UBNanosatLab/lfr-hardware/README.md

# LinkSat-comms-radio-HW
Hardware design files for the LinkSat communications radio
