UBNanosatLab/lfr-hardware/Bill of materials - rev1A.ods

RefDes | Value | Name | Part number | Quantity | note | qty to order | source
C1, C2, C22, C23 | 47uF 16V X6S 1210 | CAP_1210 | GRT32EC81C476KE13L | 4 | Alternate: GRM32ER61C476KE15L or equiv for non-flight | 12 | digikey
C3, C6, C9, C10, C11, C13, C16, C17, C18, C26 | 0.1uF 20% 25V X5R | CAP_0603_SM | CGA3E2X8R1E104K080AA | 10 |  | 25 | mouser
C4, C5, C24, C25 | 1uF 20% 10V X5R | CAP_0603_SM | CGA3E2X5R1A105M080AA | 4 |  | 15 | mouser
C7, C14 | 100pF 10% 25V C0G | CAP_0603_SM | VJ0603A101KXACW1BC | 2 |  | 5 | mouser
C8, C12, C27 | 1500pF 10% 25V C0G | CAP_0603_SM | CGA3E2C0G1H152J080AA | 3 |  | 10 | mouser
C15 | 10uF 50V X5R 1210 | CAP_1210 | UMK325BJ106MM | 1 | substituting C3225X5R1H106K250AB | 3 | digikey
C19, C20 | 10pF 10% 25V C0G | CAP_0603_SM | AC0603DRNPO9BN100 | 2 |  | 10 | mouser
C21 | 6.8pF C0G | CAP_0603_SM | 251R14S6R8CV4T | 1 | use low loss, tight tolerance parts | 10 | mouser
CF1 | 15pF C0G | CAP_0603_SM | 251R14S150JV4T | 1 | use low loss, tight tolerance parts | 10 | mouser
CF2, CF3 | DNP | CAP_0603_SM |  | 2 | use low loss, tight tolerance parts
CM1, CM2 | 6.2pF C0G | CAP_0603_SM | 251R14S6R2CV4T | 2 | use low loss, tight tolerance parts | 10 | mouser
CM3 | 11pF C0G | CAP_0603_SM | 251R14S110JV4T | 1 | use low loss, tight tolerance parts | 10 | mouser
CM4 | 10pF C0G | CAP_0603_SM | 251R14S100JV4T | 1 | use low loss, tight tolerance parts | 10 | mouser
CR1 | 4.7pF C0G | CAP_0603_SM | 251R14S4R7BV4T | 1 | use low loss, tight tolerance parts | 10 | mouser
CR2 | 2.2pF C0G | CAP_0603_SM | 251R14S2R2BV4T | 1 | use low loss, tight tolerance parts | 4 | digikey
CTX0 | 9.1pF C0G | CAP_0603_SM | 251R14S9R1CV4T | 1 | use low loss, tight tolerance parts | 10 | mouser
D1 |  | 1N4148WS-7-F |  | 1 |  | 5 | mouser
J1 |  | SMA_EDGE | CON-SMA-EDGE-S | 1 |  | 3 | digikey
J2 |  | CLT-110-02-L-D-BE | CLT-110-02-L-D-BE-A | 1 |  | 2 | digikey
L1 | 10uH | XAL7030 | XAL7030-103MEC | 1 |  | 2 | mouser
L4 | BLM21PG220SN1D | IND_0805 | BLM21PG220SN1D | 1 |  | 3 | mouser
LCHOKE | 220nH | IND_0603_SM | L-14WR22GV4E | 1 | use low loss, tight tolerance parts | 3 | mouser
LF1, LF2 | 0 ohm | IND_0603_SM |  | 2 | use low loss, tight tolerance parts
LM0 | 33nH | IND_0603_SM | L-14W33NGV4E | 1 | use low loss, tight tolerance parts | 10 | mouser
LM1, LM2 | 30nH | IND_0603_SM | LQW18AN30NJ8ZD | 2 | use low loss, tight tolerance parts | 10 | mouser
LM3 | 16nH (15?) | IND_0603_SM | LQW18AN16NJ8ZD | 1 | use low loss, tight tolerance parts | 10 | mouser
LR1 | 62nH | IND_0603_SM | LQW18AN62NG0ZD | 1 | use low loss, tight tolerance parts | 10 | mouser
LR2 | 56nH | IND_0603_SM | LQW18AN58NJ8ZD | 1 | use low loss, tight tolerance parts | 10 | mouser
wired to P1/P2/P3 | TMP36 |  | TMP36GT9Z | 1 |  | 2 | mouser
PA1 |  | RA07H4047M |  | 1
R1 | 51k 1% | RES_0603_SM | ERJ-3EKF5102V | 1 |  | 10 | mouser
R2, R11, R13 | 220k 1% | RES_0603_SM | ERJ-3EKF2203V | 3 |  | 10 | mouser
R3 | 4k7 5% | RES_0603_SM | ERJ-3EKF4701V | 1 |  | 10 | mouser
R4, R5, R6 | 10k 5% | RES_0603_SM | RK73B1JTTD103J | 3 |  | 10 | mouser
R7 | 1k 5% | RES_0603_SM | RK73B1JTTDD102J | 1 |  | 10 | mouser
R8 | 47.5k 1% | RES_0603_SM | ERJ-3EKF4752V | 1 |  | 10 | mouser
R9 | 443k 1% | RES_0603_SM | ERJ-3EKF4423V | 1 |  | 10 | mouser
R10 | R025 1% | RES_0603_SM | WSL0603R0250FEA | 1 |  | 3 | mouser
R12 | 47k 5% | RES_0603_SM | use R8 (47.5k) | 1
U1 |  | LT8611 | LT8611IUDD#PBF | 1 |  | 2 | digikey
U2 |  | SI4464 | SI4464-B1B-FMR | 1 |  | 3 | mouser
U3 |  | MCP4728 | MCP4728-E/UN | 1 |  | 3 | digikey
U4 |  | SKY13405-490LF | SKY13405-490LF | 1 | Many on hand. Do not order.
U6 |  | TPS2553 | TPS2553DBVR | 1 |  | 2 | mouser
U7 |  | MSP430FR5994IPM | MSP430FR5994IPMR | 1 |  | 2 | mouser
XO1 |  | 520L15IA26M0000 |  | 1 |  | 3 | mouser
Y1 | 16MHz | CX3225SB16000H0FLJCC |  | 1 |  | 3 | digikey
Tuning components
Capacitors
 | 2.0pF | 251R14S2R0BV4T |  |  |  | 10 | mouser
2.2pF C0G
 | 2.7pF | 251R14S2R7BV4T |  |  |  | 10 | mouser
 | 3.9pF | 251R14S3R9BV4T |  |  |  | 10 | mouser
4.7pF C0G
 | 5.1pF | 251R14S5R1CV4T |  |  |  | 10 | mouser
 | 5.6pF | 251R14S5R6CV4T |  |  |  | 10 | mouser
6.2pF C0G
6.8pF C0G
 | 7.5pF | 251R14S7R5CV4T |  |  |  | 10 | mouser
 | 8.2pF | 251R14S8R2CV4T |  |  |  | 10 | mouser
9.1pF C0G
10pF C0G
11pF C0G |  |  |  |  |  | 10 | mouser
 | 12pF | 251R14S120JV4T |  |  |  | 10 | mouser
 | 13pF | 251R14S130JV4T
15pF C0G
Inductors
 | 13nH | LQW18AN13NJ8ZD |  |  |  | 5
 | 15nH | LQW18AN15NJ8ZD |  |  |  | 5
16nH (15?)
 | 18nH | LQW18AN18NJ8ZD |  |  |  | 5 | mouser
 | 27nH | LQW18AN27NJ8ZD |  |  |  | 10 | mouser
30nH
33nH
 | 36nH | LQW18AN36NJ8ZD |  |  |  | 5 | mouser
