UBNanosatLab/lfr-hardware/Schematic - LinkSat radio rev1.pdf

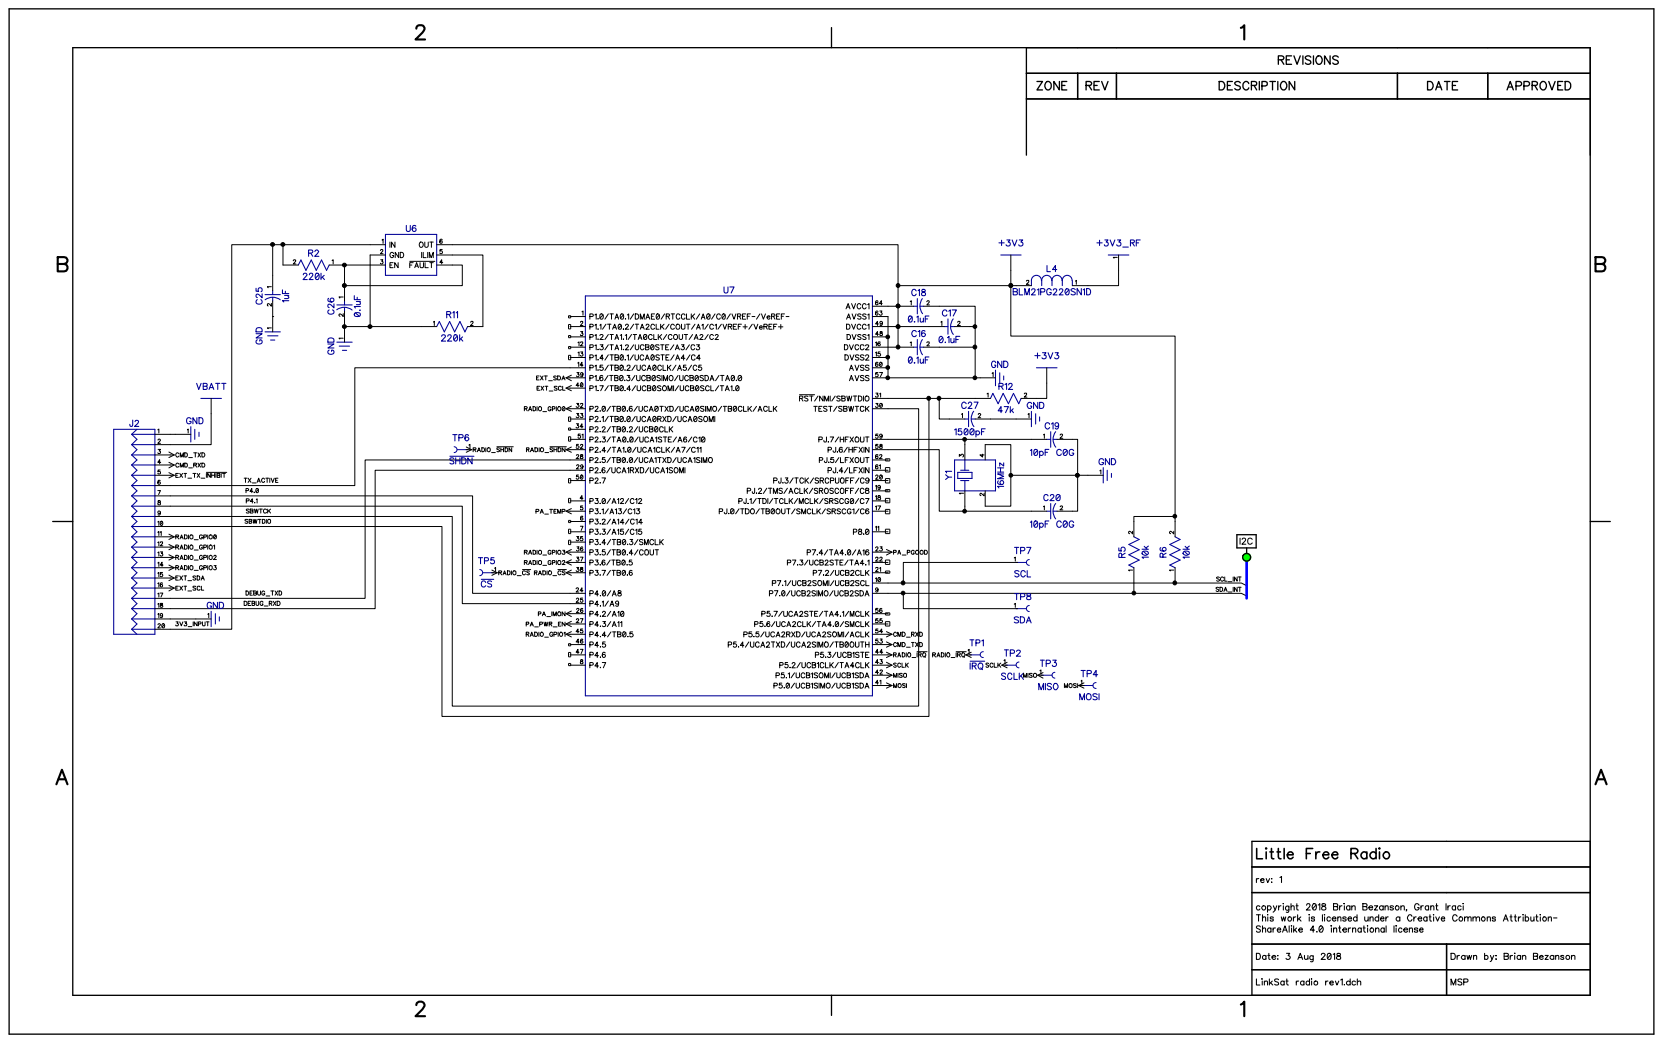
[picture p1: page 1]

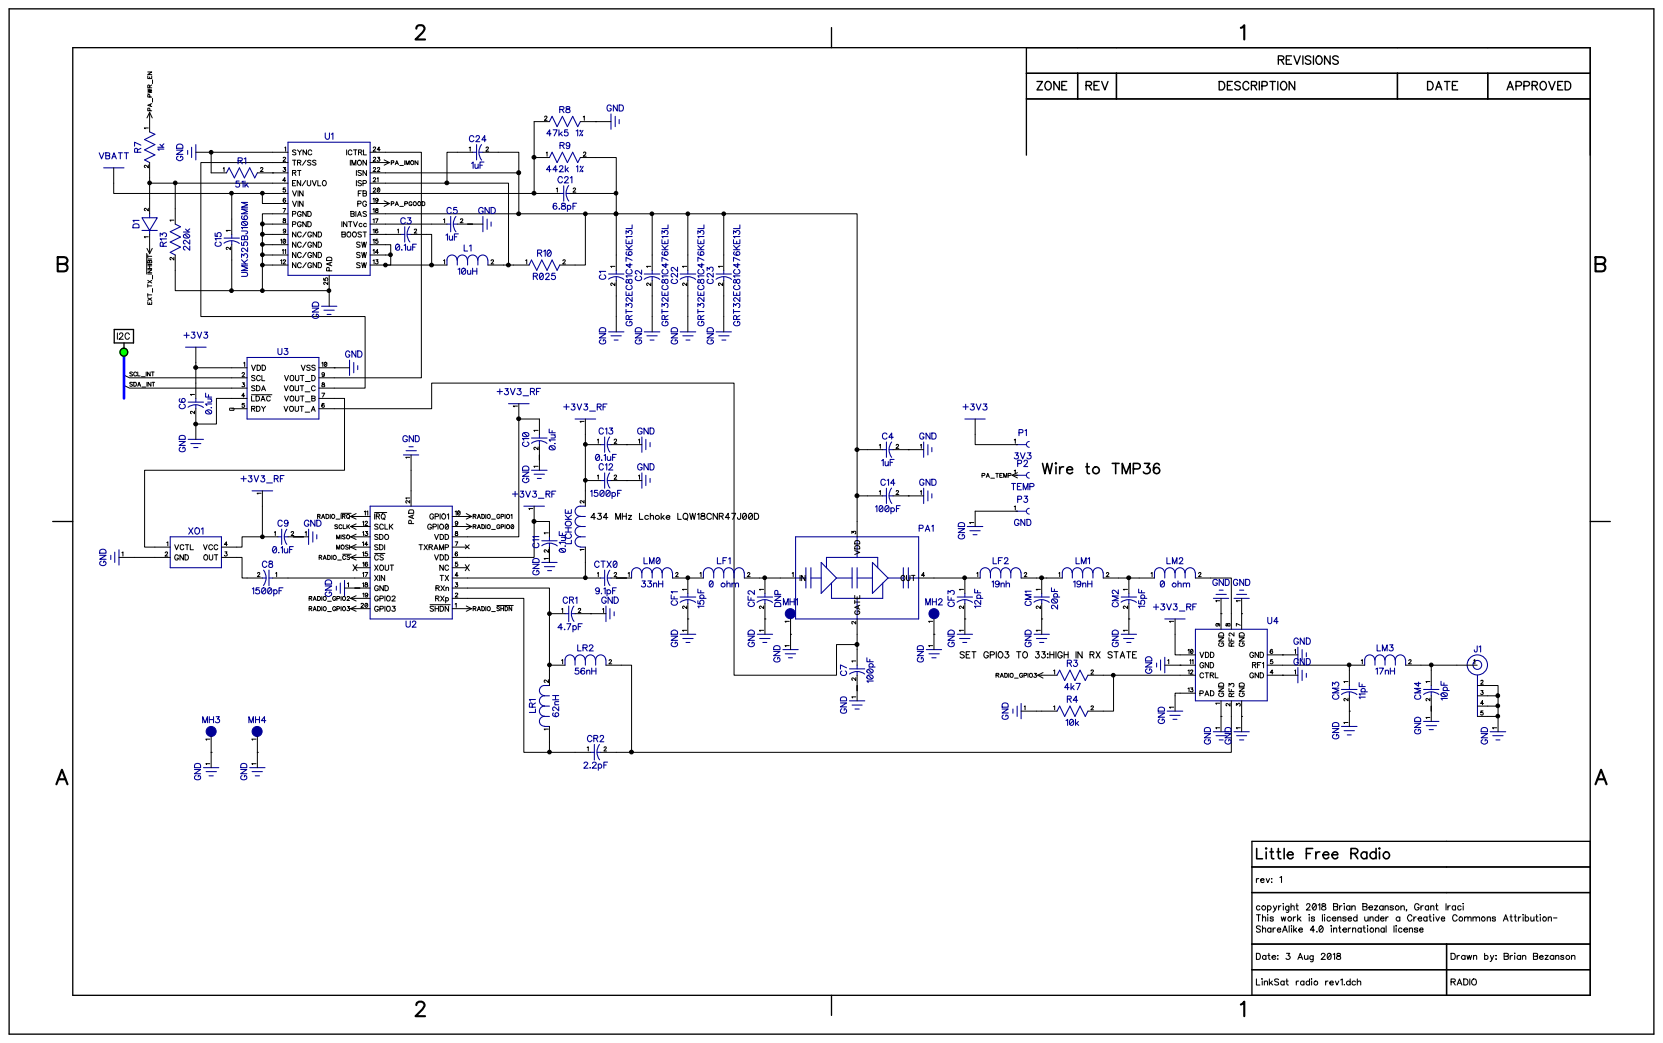
[picture p2: page 2]
