UBNanosatLab/lfr-hardware/PCB - LinkSat radio rev1A.pdf

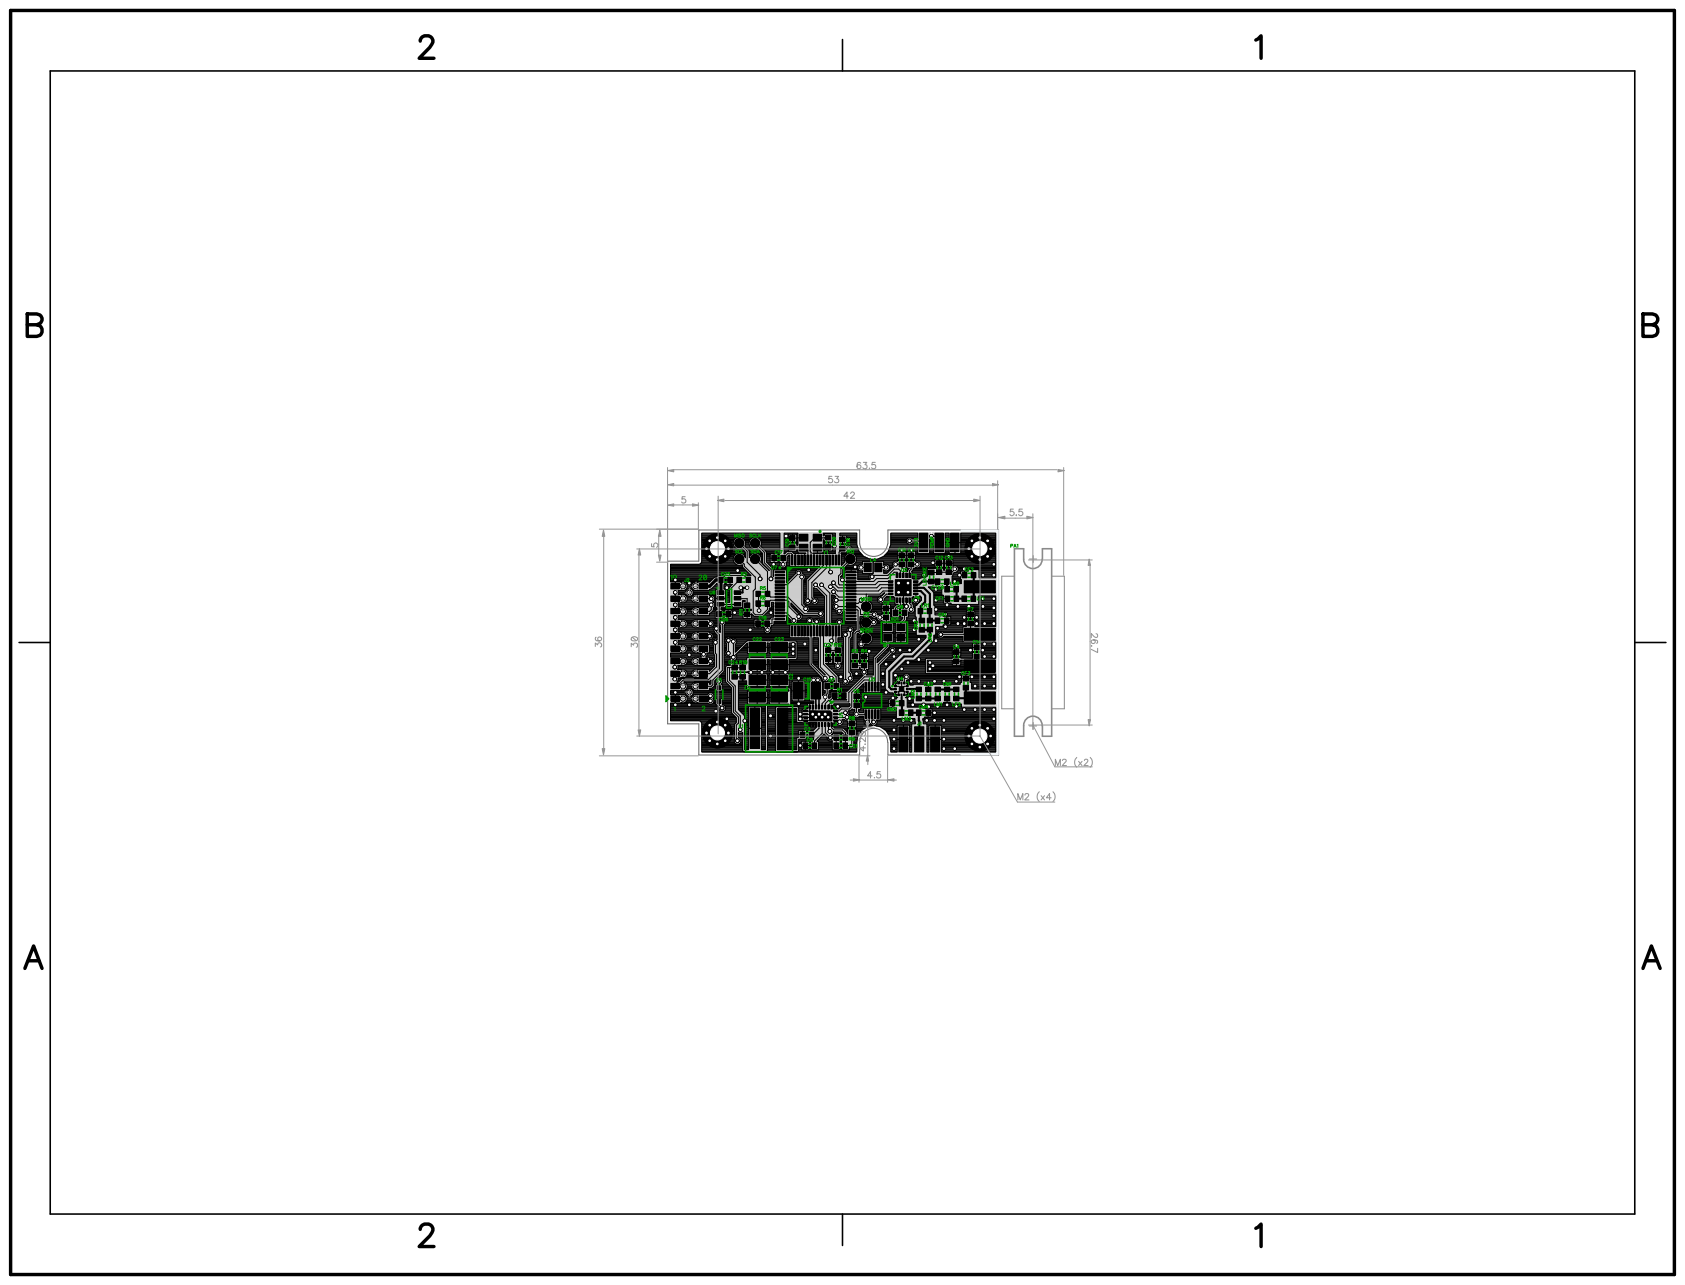
[picture p3: page 1]
