UBNanosatLab/lfr-hardware/(list of files, drawings)

Other design files:
Adapter for LFR.dch
Adapter for LFR.dip
Adapter rev A for LinkSat radio rev1.dch
Adapter rev A for LinkSat radio rev1A.dip
LFR Layout.dip
LFR Schematic.dch
LinkSat radio rev1.dch
LinkSat radio rev1A.dip
LinkSat radio rev1B.dip
