UBNanosatLab/lfr-hardware/(threads)

Thread 6 (2018-06-29):

Allow DAC power cycle

brianbezanson, 2018-06-29:
The DAC tends to remain permanently confused if an error occurs while talking to it.  A power switch should be added so it can be reset to a known state.

brianbezanson, 2018-09-26:
Implemented in 85315b9b973b8714695c9d8848402f542346ebcc

Closed 2018-09-26.

Thread 8 (2018-08-04):

Test fixture fixes and features

brianbezanson, 2018-08-04:
- [x] Mounting holes matching PCB and case
- [x] Power LEDs fed from VBUS
- [x] Fix pin label silkscreen
- [x] Rearrange tall components away from target board
- [x] Enlarge pads for polyfuse
- [x] Add manual reset button

brianbezanson, 2018-10-30:
Implemented in c7d959d6549c4f69e93ee9953607b56048bbdcc2 through 80d0a64b5b98f98f1e395d351297a4a5bb2d4a53

Closed 2018-10-30.

Thread 9 (2018-08-04):

Hardware version ID

brianbezanson, 2018-08-04:
Encode a hardware version ID in a set of grounded/unconnected pins on the MSP430, so that firmware can read them by enabling pull-up resistors.

brianbezanson, 2018-09-26:
Implemented in 85315b9b973b8714695c9d8848402f542346ebcc

Closed 2018-09-26.

Thread 11 (2018-08-05):

Change J2 for easier top-side mating

brianbezanson, 2018-08-05:
Options:
https://www.digikey.com/product-detail/en/sullins-connector-solutions/NPPN102GFNP-RC/S6013-10-ND/810107 (requires larger alignment hole)

https://www.digikey.com/product-detail/en/3m/153220-2020-RB-WC/3M5418CT-ND/1145366 (requires larger alignment hole)

https://www.digikey.com/product-detail/en/harwin-inc/M22-6361042/952-1833-ND/3727800 (appears directly compatible)

brianbezanson, 2019-01-19:
Implemented in e2926a3257469e161404f3ee247a9092237667d3

Closed 2019-01-19.

Thread 12 (2018-08-08):

PCB mechanical changes

brianbezanson, 2018-08-08:
- [x] Round convex corners to allow easier fit into a milled case, whose interior corners are rounded.
- [x] Square off mid-side notches to ease case machining

brianbezanson, 2018-09-27:
Chamfered corners instead of rounding.  Implemented in 90785bc

Closed 2018-09-27.

Thread 13 (2018-08-18):

Add finite-time transmit enable circuit

brianbezanson, 2018-08-18:
Add an RC time limiter to the microcontroller->buck converter enable connection.

brianbezanson, 2018-09-26:
Implemented in afffd9d6f03e8a5345c89d173241364c43b7a1e7

Closed 2018-09-26.

Thread 14 (2018-09-26):

Reassign pins to expose UART BSL

brianbezanson, 2018-09-26:
The UART bootloader in the MSP430FR5994 is hard-wired to P2.0/P2.1 (UCA0TXT/UCA0RXD).  Pins and peripherals should be reassigned to use this as the debug UART, so firmware may be updated through the normal flight computer interface without writing our own bootloader.

brianbezanson, 2018-09-27:
Implemented in fad31a2.  Also reassigned the uncommitted GPIOs from P4.0/4.1 to P1.4/1.5, so the debug UART USCI may be run in SPI mode as well.

Closed 2018-09-27.

Thread 15 (2019-01-19):

Comparator VDD monitor

brianbezanson, 2019-01-19:
Since the LT8611's PGOOD signal only asserts when the PA_VSET reference is set to full-scale, another means of detecting voltage dropout upon entering constant-current mode is needed.

A voltage divider that nominally scales VDD down to a few percent higher than VSET should allow the MSP430's comparator to fire an interrupt at the onset of voltage dropout.

Thread 16 (2019-01-21):

New test/adapter board features

brianbezanson, 2019-01-21:
- [x] Place radio's SMA connector at the board edge
- [x] Add voltage/current monitors for VBATT and 3.3V (I2C interface? 'duino/teensy/something?)
- [x] Improve power path switching -- have options for VBUS -> VBATT, VBUS -> 3.3V LDO, VBATT -> 3.3V LDO (AP2204 LDO?)

Closed 2019-08-17.

Thread 17 (2019-01-21):

Direct over-the-air command of radio

brianbezanson, 2019-01-21:
Control radio behavior through CCSDS-compliant commands over the air
- [ ] Reset radio
- [ ] Set or read GPIO pins
- [ ] Adjust clear channel threshold
- [ ] UART/SPI/I2C send/receive
- [ ] OTA firmware update
- [ ] Direct access to flight computer's flash, upload new software

Thread 19 (2019-01-22):

Low PA output

brianbezanson, 2019-01-22:
RF output power looks low, based on preliminary measurements.  Current draw measurements suggest the uncalibrated RF measurements aren't wrong by very much.  Fix that.

brianbezanson, 2019-02-06:
The output harmonic filter is overly lossy, and the T/R switch has exhibited suspiciously high loss.  The harmonic filter has been reduced to a low-loss pi filter and the switch replaced with a part rated for 20W CW.  Won't close until testing is done.

Thread 21 (2019-08-08):

UHF PA input match

brianbezanson, 2019-08-08:
Extend movable range of tuning capacitor, or replace variable length microstrip with series inductor.
