UBNanosatLab/lfr-hardware/(commit log)

2018-05-03 Created initial schematic and layout files
    [LinkSat radio rev1.dch, LinkSat radio rev1A.dip]
2018-05-03 Moved connector to top side, adjusted pinout
    [LinkSat radio rev1.dch, LinkSat radio rev1A.dip]
2018-05-04 Added test points for SPI/radio signals
    [LinkSat radio rev1.dch]
2018-05-04 Test points, outline change to allow mounting screws
    [LinkSat radio rev1A.dip]
2018-05-05 Screw cutouts and more test points
    [LinkSat radio rev1.dch, LinkSat radio rev1A.dip]
2018-05-10 Added bill of materials
    [Bill of materials.ods]
2018-05-10 Minor layout tweaks
    [LinkSat radio rev1A.dip]
2018-05-15 Uh, something, before changing connector pin count
    [LinkSat radio rev1A.dip]
2018-05-15 Created bill of materials file
    [Bill of materials.csv]
2018-05-15 Reduced J2 to 20 pins
    [LinkSat radio rev1.dch, LinkSat radio rev1A.dip]
2018-05-15 Layout tweaks and refdes cleanup
    [LinkSat radio rev1.dch, LinkSat radio rev1A.dip]
2018-06-29 Inhibit changes - 1k and add weak pull down
    [LinkSat radio rev1.dch, LinkSat radio rev1A.dip]
2018-06-29 Revision in silkscreen
    [LinkSat radio rev1A.dip]
2018-06-29 Paste mask
    [LinkSat radio rev1A.dip]
2018-07-04 Corrected mounting hole position
    [LinkSat radio rev1B.dip]
2018-07-06 Created adapter/pogo pin board
    [Adapter rev A for LinkSat radio rev1.dch, Adapter rev A for LinkSat radio rev1A.dip]
2018-07-06 Beefed up buck converter, general edits
    [Adapter rev A for LinkSat radio rev1.dch, Adapter rev A for LinkSat radio rev1A.dip]
2018-07-06 Resolved DRC issue
    [Adapter rev A for LinkSat radio rev1A.dip]
2018-07-09 Ordering adapter board
    [Adapter rev A for LinkSat radio rev1A.dip]
2018-07-12 Set values for buck converter resistor divider
    [LinkSat radio rev1.dch]
2018-07-12 Add Bill of Materials with some extra parts
    [Bill of materials - rev1A.ods]
2018-07-12 BOM edit
    [Bill of materials - rev1A.ods]
2018-08-03 Experimentally derived matching component values
    [LinkSat radio rev1.dch]
2018-08-07 Update title blocks
    [LinkSat radio rev1.dch, LinkSat radio rev1A.dip, LinkSat radio rev1B.dip]
2018-08-08 Schematic and layout PDFs
2018-09-26 Leftover changes?
    [LinkSat radio rev1B.dip]
2018-09-26 Removed revision from filenames and added DAC power control
    [LFR Layout.dip, LFR Schematic.dch]
2018-09-26 Added RC time limit to TX VDD enable
    [LFR Layout.dip, LFR Schematic.dch]
2018-09-26 Added test points for PA_VDD, IMON, PGOOD
    [LFR Layout.dip, LFR Schematic.dch]
2018-09-27 Chamfered corners to simplify enclosure machining
    [LFR Layout.dip]
2018-09-27 Added ground plane relief under RF connector pads
    [LFR Layout.dip]
2018-09-27 Reassigned debug UART to UCA0 for bootstrap loader use
    [LFR Layout.dip, LFR Schematic.dch]
2018-09-27 Schematic cosmetics and silkscreen update
    [LFR Layout.dip, LFR Schematic.dch]
2018-09-27 Add proper bulk capacitance on 3V3
    [LFR Layout.dip, LFR Schematic.dch]
2018-10-17 Redid layout of pogo/adapter board and added reset switch
    [Adapter for LFR.dch, Adapter for LFR.dip]
2018-10-28 Silkscreen update and minor trace tweaks
    [Adapter for LFR.dip]
2018-10-28 Propagated schematic changes for LEDs to layout
    [Adapter for LFR.dip]
2018-10-28 Synchronized mounting holes between schematic and layout
    [Adapter for LFR.dch, Adapter for LFR.dip]
2018-10-28 Minor layout improvements
    [Adapter for LFR.dip]
2018-10-30 Minor trace corrections, moved silk away from mounting hole
    [Adapter for LFR.dip]
2018-11-15 Changed 2mm header to Sullins, extended outline by 0.5mm
    [LFR Layout.dip, LFR Schematic.dch]
2019-01-09 Reduced PCB width at header connector
    [LFR Layout.dip]
2019-01-10 Added stand-in 3D model for SMA connector
    [LFR Layout.dip]
2019-01-11 Chamfered corners near header
    [LFR Layout.dip]
2019-01-11 Reduced board notch depth, edited dimension callouts
    [LFR Layout.dip]
2019-01-18 Redesigned output filter for reduced loss and option of more post-switch harmonic blocking
    [LFR Schematic.dch]
2019-01-19 Added T/R switch bypass resistor
    [LFR Schematic.dch]
2019-01-19 Added PA_VDD divider and reallocated pins to get it to the comparator. Closed #15.
    [LFR Layout.dip, LFR Schematic.dch]
2019-01-19 Silkscreen and minor tweaks
    [LFR Layout.dip]
2019-01-20 Significant relayout for new features
    [LFR Layout.dip]
2019-01-22 Reassigned SHDN pin
    [LFR Layout.dip, LFR Schematic.dch]
2019-01-22 Restored PA temperature sensor
    [LFR Layout.dip, LFR Schematic.dch]
2019-01-23 Adapter updates
    [Adapter for LFR.dch, LFR Layout.dip]
2019-01-23 Add power monitoring to adapter
    [Adapter for LFR.dch]
2019-01-26 Added 3V3_RF bulk cap and SiLabs' RC VDD filter
    [LFR Layout.dip, LFR Schematic.dch]
2019-01-27 Connected GPIO1 to P1.0/DMAE0
    [LFR Layout.dip, LFR Schematic.dch]
2019-01-27 Moved GPIO0 to timer B clock input
    [LFR Layout.dip, LFR Schematic.dch]
2019-02-04 More ground relief and minor edits
    [LFR Layout.dip]
2019-02-05 Lower loss TX filter
    [LFR Layout.dip, LFR Schematic.dch]
2019-02-05 High power T/R switch
    [LFR Layout.dip, LFR Schematic.dch]
2019-02-06 Silkscreen marking
    [LFR Layout.dip]
2019-02-07 Correct rev 2A hole pattern
    [Adapter for LFR.dch, Adapter for LFR.dip]
2019-03-10 Can't get 1000pF hi-Q caps in 0603, using 100pF for DC blocking at CR3
    [LFR Layout.dip, LFR Schematic.dch]
2019-03-11 Reduced output filter caps to improve 435 MHz S12
    [LFR Layout.dip, LFR Schematic.dch]
2019-03-12 Missed a cap
    [LFR Schematic.dch]
2019-03-12 Messed with adapter layout
    [Adapter for LFR.dip]
2019-03-14 Corrected DAC power mosfet
    [LFR Schematic.dch]
